bobbyhyson/ColorChangingGlucosePatch/Custom Libraries/LMC6484AIN_NOPB-2/LMC6484AIN_NOPB.step

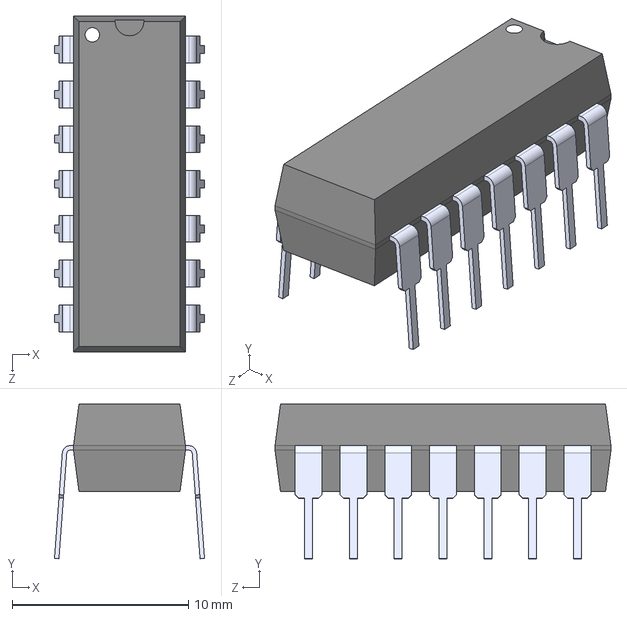
[picture p1: CAD file, 2025-11-18]
Custom Libraries/LMC6484AIN_NOPB-2/LMC6484AIN_NOPB.step
8.51 x 8.76 x 19.1 mm
