bobbyhyson/ColorChangingGlucosePatch/Custom Libraries/LMC6484AIN_NOPB.STEP

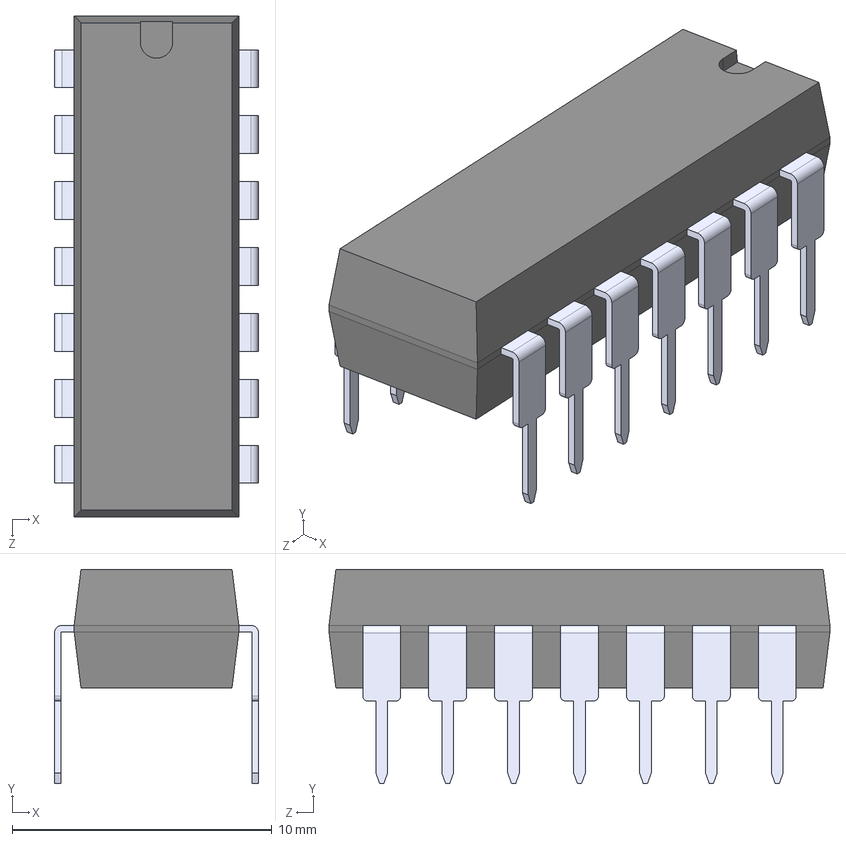
[picture p2: CAD file, 2025-11-18]
Custom Libraries/LMC6484AIN_NOPB.STEP
7.87 x 8.26 x 19.3 mm
