bobbyhyson/ColorChangingGlucosePatch/Custom Libraries/LMC6484IMX_NOPB/D0014A.stp

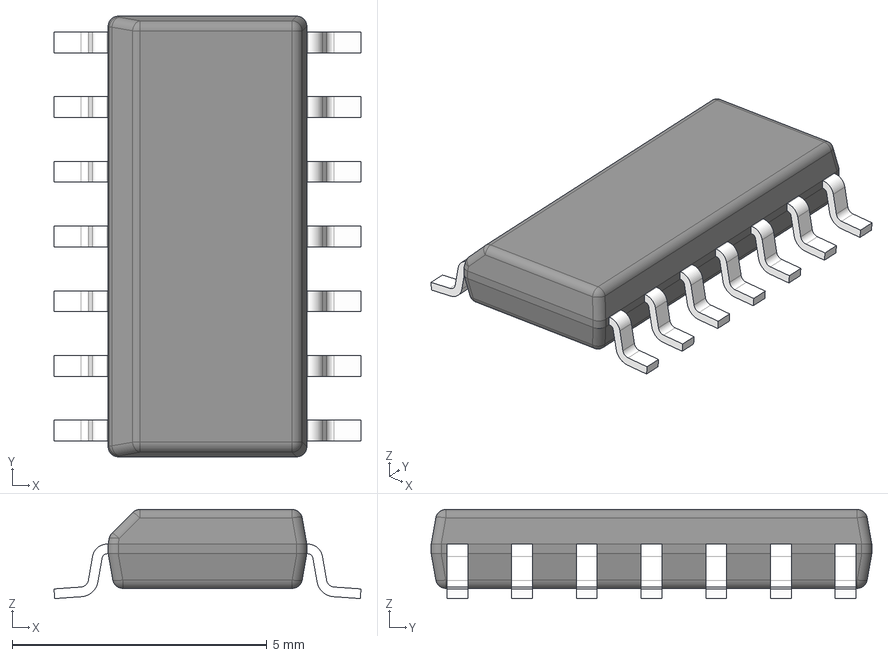
[picture p3: CAD file, 2025-11-18]
Custom Libraries/LMC6484IMX_NOPB/D0014A.stp
6.03 x 8.65 x 1.75 mm
BODY-SO
LEAD-SO x 14
PIN1-ID
