bobbyhyson/ColorChangingGlucosePatch/Custom Libraries/LTST_C190YKT-2/LTST-C190YKT.step

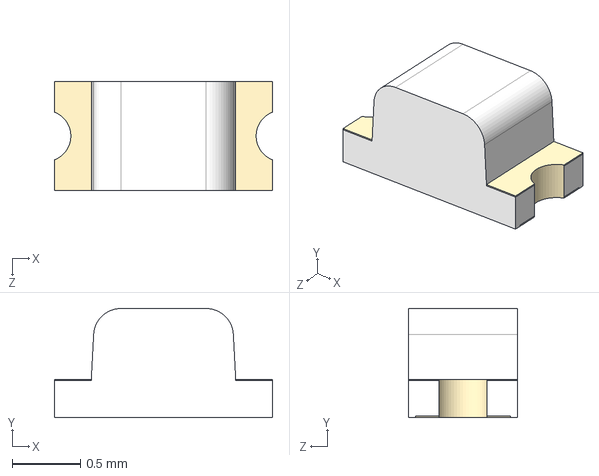
[picture p4: CAD file, 2025-11-19]
Custom Libraries/LTST_C190YKT-2/LTST-C190YKT.step
1.60 x 0.8 x 0.8 mm
