bobbyhyson/ColorChangingGlucosePatch/Custom Libraries/LTST_S270KRKT-3/LTST-S270KRKT.step

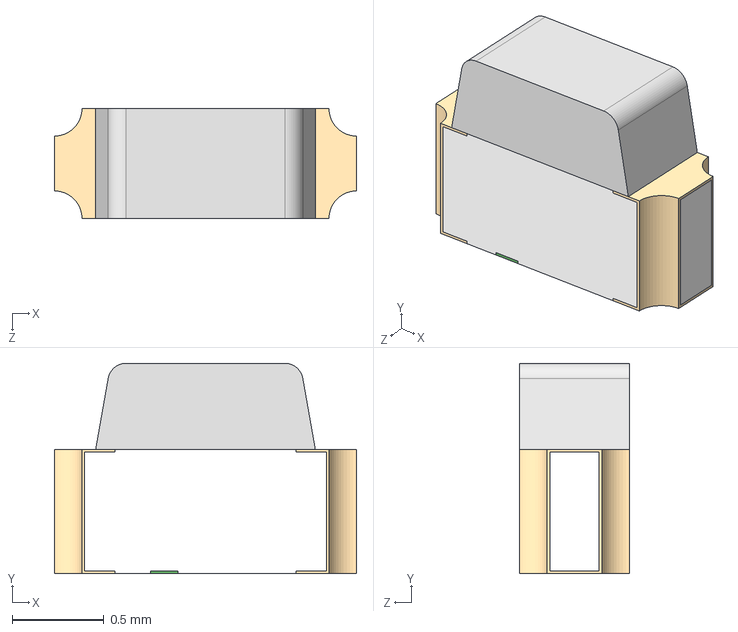
[picture p5: CAD file, 2025-11-19]
Custom Libraries/LTST_S270KRKT-3/LTST-S270KRKT.step
1.65 x 1.15 x 0.6 mm
