bobbyhyson/ColorChangingGlucosePatch/Custom Libraries/MAX4575EUA_/21-0036K.step

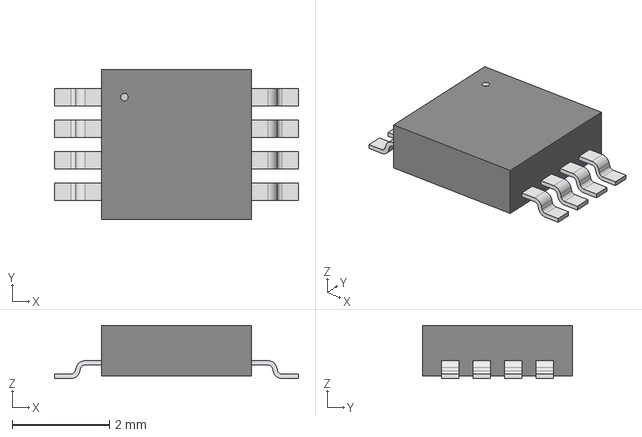
[picture p6: CAD file, 2025-11-19]
Custom Libraries/MAX4575EUA_/21-0036K.step
5.03 x 3.10 x 1.09 mm
