bobbyhyson/ColorChangingGlucosePatch/TPS76925DBVR/TPS76925DBVR.step

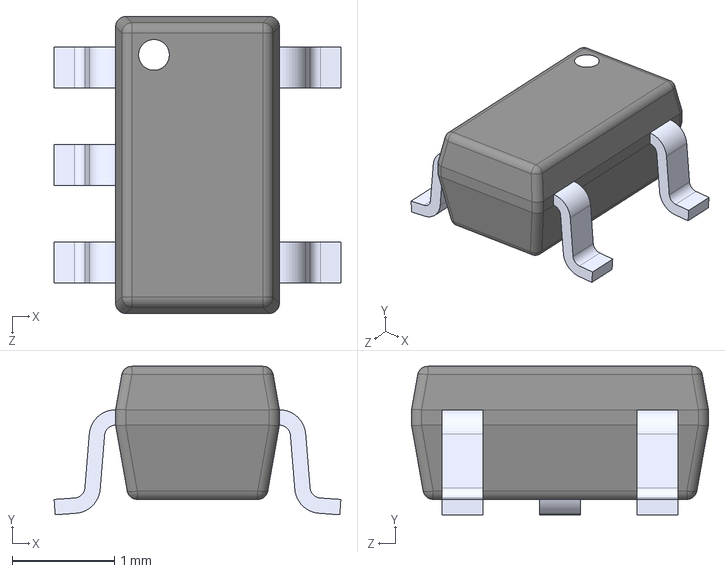
[picture p7: CAD file, 2025-11-19]
TPS76925DBVR/TPS76925DBVR.step
2.80 x 1.45 x 2.90 mm
