bobbyhyson/ColorChangingGlucosePatch/(list of files, cad)

Other CAD files:
Custom Libraries/LMC6484IMX_NOPB (1)/LMC6484IM.step
