bobbyhyson/ColorChangingGlucosePatch/circuit diagram.pdf

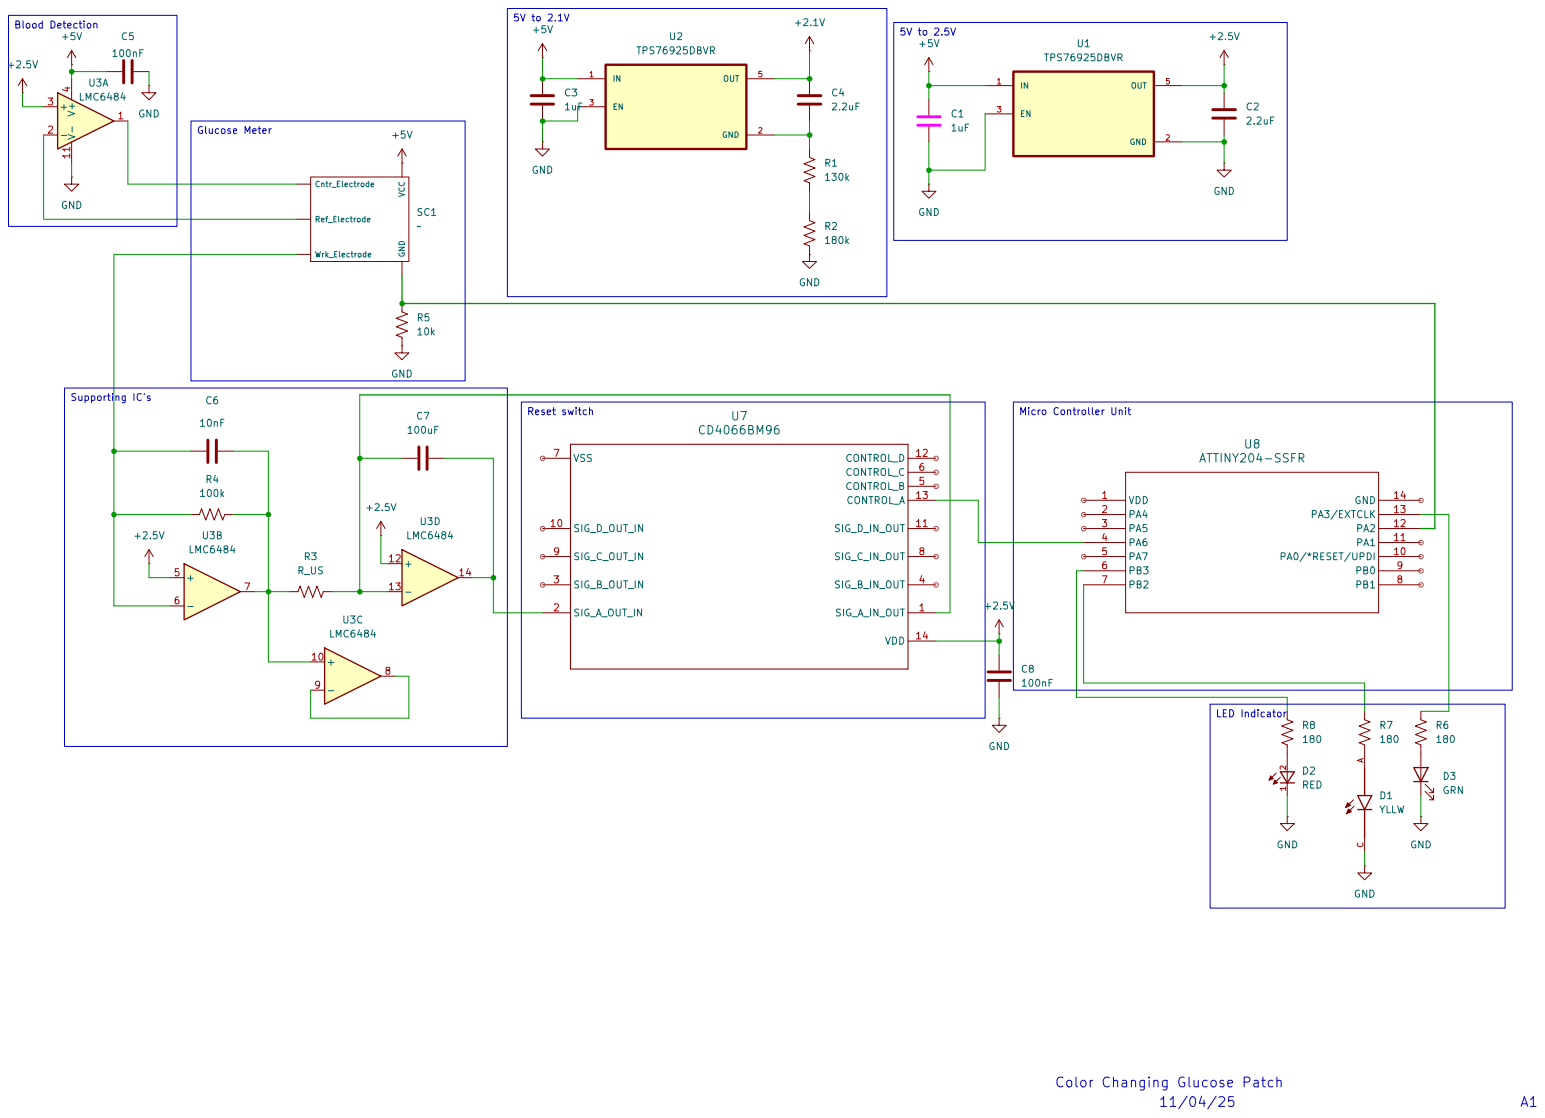
[picture p8: page 1]
