bobbyhyson/ColorChangingGlucosePatch/ColorChangingGlucosePatch.kicad_pcb

## KiCad design ColorChangingGlucosePatch.kicad_pcb (2025-11-20)

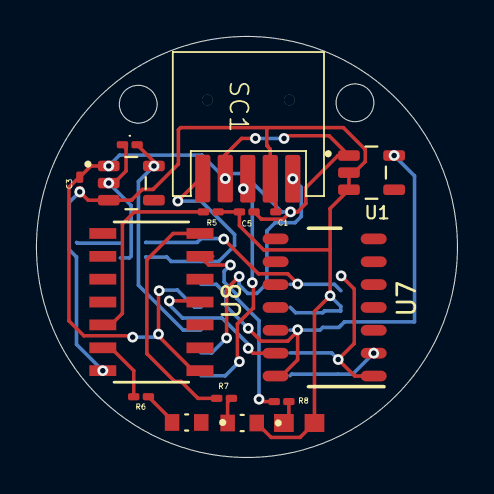
[picture p9: board ColorChangingGlucosePatch.kicad_pcb from above]

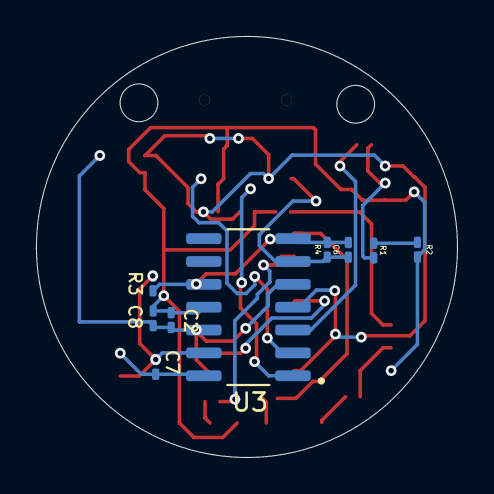
[picture p10: board ColorChangingGlucosePatch.kicad_pcb from below]

Board: 2 copper layers, 23.4 x 23.4 mm, 25 parts (9 on the bottom side), 21 nets.

Parts:
C1, C3: 1uF; C_0201_0603Metric_Pad0.64x0.40mm_HandSolder
C2, C4: 2.2uF; C_0201_0603Metric_Pad0.64x0.40mm_HandSolder
C5, C8: 100nF; C_0201_0603Metric_Pad0.64x0.40mm_HandSolder
C6: 10nF; C_0201_0603Metric_Pad0.64x0.40mm_HandSolder
C7: 100uF; C_0201_0603Metric_Pad0.64x0.40mm_HandSolder
D1: YLLW; LEDC1608X35N
D2: RED; 0603
D3: GRN; LEDC1608X35N
R1: 130k; C_0201_0603Metric_Pad0.64x0.40mm_HandSolder
R2: 180k; C_0201_0603Metric_Pad0.64x0.40mm_HandSolder
R3, R4: 100k; C_0201_0603Metric_Pad0.64x0.40mm_HandSolder
R5: 10k; C_0201_0603Metric_Pad0.64x0.40mm_HandSolder
R6, R7, R8: 180; C_0201_0603Metric_Pad0.64x0.40mm_HandSolder
SC1: Strip-Connector
U1, U2: TPS76925DBVR; SOT95P280X145-5N
U3: LMC6484; SOIC127P600X175-14N
U7: CD4066BM96; D0014A_N
U8: ATTINY204-SSFR; SOIC14_SL_MCH

Connections:
+2.1V: C4.1, U2.5 (OUT), U3.3 (+)
+2.5V: C2.1, C8.1, U1.5 (OUT), U3.5 (+), U3.12 (+), U7.14 (VDD)
+5V: C1.1, C3.1, C5.1, SC1.4, U1.1 (IN), U2.1 (IN), U3.4 (V+), U8.1 (VDD)
GND: C1.2, C2.2, C3.2, C5.2, C8.2, D1.C, D2.1, D3.C, R2.2, R5.2, SC1.2, U1.2 (GND), U1.3 (EN), U2.3 (EN), U3.11 (V-), U8.14 (GND)
unnamed: D1.A, R7.2
unnamed: D2.2, R8.2
unnamed: D3.A, R6.2
unnamed: R1.2, R2.1
unnamed: SC1.3, U3.1
unnamed: R5.1, U8.12 (PA2)
unnamed: SC1.1, U3.2 (-)
unnamed: C6.1, R4.1, SC1.5, U3.6 (-)
unnamed: C4.2, R1.1, U2.2 (GND)
unnamed: C6.2, R3.1, R4.2, U3.7, U3.10 (+)
unnamed: U3.8, U3.9 (-)
unnamed: C7.1, R3.2, U3.13 (-), U7.1 (SIG_A_IN_OUT)
unnamed: U7.13 (CONTROL_A), U8.4 (PA6)
unnamed: C7.2, U3.14, U7.2 (SIG_A_OUT_IN)
unnamed: R6.1, U8.13 (PA3/EXTCLK)
unnamed: R7.1, U8.7 (PB2)
unnamed: R8.1, U8.6 (PB3)
