bobbyhyson/ColorChangingGlucosePatch/(commit log)

2025-11-11 work please
    [ColorChangingGlucosePatch.kicad_pcb, ColorChangingGlucosePatch.kicad_sch]
2025-11-14 more stuff
    [ColorChangingGlucosePatch.kicad_sch]
2025-11-18 holy shit its working
    [ColorChangingGlucosePatch.kicad_sch, LMC6484AIN_NOPB.STEP, LMC6484AIN_NOPB.step]
2025-11-19 late to gym oh no
    [ColorChangingGlucosePatch.kicad_pcb, LTST-C190YKT.step, LTST-S270KRKT.step]
2025-11-19 oh no
    [TPS76925DBVR.step]
2025-11-19 final version but its not because im probably gonna work on it tomorrow.
    [21-0036K.step, ColorChangingGlucosePatch.kicad_pcb, ColorChangingGlucosePatch.kicad_sch, D0014A.stp, LMC6484IM.step]
2025-11-19 fuck this
    [ColorChangingGlucosePatch.kicad_sch]
2025-11-20 final revision but not really
    [ColorChangingGlucosePatch.kicad_pcb, ColorChangingGlucosePatch.kicad_sch]
